emre-sevinc/EE463-Project/sim_v12.asc

C1: cap; 600µ
C2: cap; 10m
C3: cap; 470p
C5: cap; 3.3n
D1: diode; VS-E5TH1512
D2: diode; VS-E5TH1512
D3: diode; VS-E5TH1512
D4: diode; VS-E5TH1512
D5: diode; VS-E5TH1512
D7: diode; VS-E5TH1512
D8: diode; VS-E5TH1512
L1: ind; 1.08m
L2: ind; 24.5m
M1: nmos; IPB65R420CFD
R1: res; 20
R2: res; 0.2
R3: res; 1k
R4: res; 10k
R5: res; 1.07
R6: res; 10
R7: res; 390k
R8: res; 5.6k
R11: res; 10k
R14: res; 47k
R15: res; 0.05
U1: opamp2; TLP250
U3: LT1246
V1: voltage; SINE(0 325 50 0 0 0 0)
V2: voltage; SINE(0 325 50 0 0 120 0)
V3: voltage; SINE(0 325 50 0 0 240 0)
V4: voltage; 15
V5: voltage; 5; Rser=0
V7: voltage; 18V
V8: voltage; 15
Named nets: 5v, 0, 15v, 15v2, source, gate, 18v
.tran 0 10m 0 100n uic
.SUBCKT TLP250 A K VCC EE VO
* Toshiba TLP250 Behavioral Model
* Pinout: A=Anode(2), K=Cathode(3), VCC=Supply(8), EE=GND(5), VO=Output(6/7)
* Input LED Stage
R1 A 2 1k
D1 2 K DLED
.MODEL DLED D(Is=1e-15 N=1 Rs=5)
* Current Sensing
E_sense 3_dum 0 VALUE={I(D1)}
* Output Switch Stage with Delay (Approx 150ns-500ns)
B_out VO_int 0 V = V(3_dum)>1m ? V(VCC) : V(EE)
R_out VO_int VO 10   ; Output Impedance approx 10 ohms
C_delay VO_int 0 200p ; Simulation of delay
* Power consumption dummy
R_supply VCC EE 10Meg
.ENDS TLP250
