emre-sevinc/EE463-Project/(commit log)

2025-11-24 Open loop simulation in ltspice is finalized. Retifier and buck converter is merged
2025-12-05 Last update of LTSpice
    Gate driver is added in Ltspice.
